ShyavanS/Ultrasonic-Range-Finder-Design-Project/(list of files, drawings)

Other design files:
Design Project Circuit Design.ms14
